thefhiter/masoud/docs/wiring.html

# Masoud wiring

Arduino Uno, the 1.8" screen and the two speakers, with or without the PAM8403 amp. Every pin is labeled as it is printed on the boards. Unplug the USB while you wire, and tick each wire below as you go.

Without amp 1 resistor, quieter With amp PAM8403, louder

1 Screen: 7 wires2 Speakers: 1 resistor, 4 wires

1 Screen: 7 wires2 Amp: 3 wires3 Speakers: 4 wires

The screen takes 3.3V, never 5V. Without the amp, the 220 Ω resistor is not optional: a speaker straight on D3 would burn the pin. The amp takes 5V. Don't swap it with the screen's 3.3V. Nothing goes on D9 or D10 except the screen: those pins drive it.

Without the amp: D3, a 220 Ω resistor, speaker 1, speaker 2, back to GND, all in one loop (the speakers are in series). The screen keeps the same 7 wires; switch to "With amp" to see them drawn.

Top: the screen's 10 pins (3 stay empty). Middle: the Arduino, pins named as printed next to its headers. Right: the amp with its input, power and speaker pins, then the two speakers.

## Wire by wire

0 wires done

### 1 · Screen

Screen VCC→Uno 3.3VBottom header, POWER side. Never 5V. Screen GND→Uno GNDTop header, next to AREF (any GND works). Screen SCK→Uno 13Clock. Screen MOSI→Uno ~11Data. Not MISO, the pin next to it. Screen LCD_CS→Uno ~10Not RAM_CS, the pin next to it. Screen DC→Uno ~9 Screen RST→Uno 8MISO, RAM_CS and BL stay empty.

### 2 · Speakers, no amp

Uno ~3→Resistor, leg 1Either leg: a resistor has no direction. Resistor, leg 2→Speaker 1, wire 1220 Ω = red, red, brown stripes. 150 to 330 Ω also works. Speaker 1, wire 2→Speaker 2, wire 1Speakers in series. Their wires have no direction either. Speaker 2, wire 2→Uno GNDAny GND pin.

### 2 · Amp

Uno ~3→Amp L and ROne wire from D3, split to both inputs. Same sound on both speakers. Uno 5V→Amp +5VMay be printed VCC, 5V or +. Uno GND→Amp GNDPower ground, printed GND or −. The input's G can stay empty.

### 3 · Speakers

Speaker 1, wire 1→Amp L+The + wire if your speaker is marked. Speaker 1, wire 2→Amp L−L− is not ground: never join it to GND. Speaker 2, wire 1→Amp R+ Speaker 2, wire 2→Amp R−R− is not ground either.

Clear all ticks

## Finding the pins on your amp

PAM8403 boards come in a few versions and print the same pins with different names. Match yours here.

Input (from the Arduino)

L R plus a ground marked G, ⏚ or GND. Sometimes LIN / RIN. Usually a row of 3 small pins on one edge.

Power

+5V, VCC or + takes the Uno's 5V. GND or − takes the Uno's GND. Usually 2 pins, sometimes marked in red.

Speakers

L+ L− and R+ R−, or LOUT+ LOUT−, ROUT+ ROUT−. On boards with 2 screw terminals, the one marked L is speaker 1 and the one marked R is speaker 2.

If your board looks different, send a photo of it in the chat and the pins will be marked for you.

## Before you plug in the USB

1. Screen VCC is on 3.3V, not 5V.
2. The resistor sits between D3 and the speakers, never left out.
3. No speaker wire touches GND or the Arduino.
4. D9 and D10 only go to the screen (DC and LCD_CS).
5. Bare wire ends don't touch each other, especially under the amp.
