thefhiter/masoud/(commit log)

2026-10-15 Masoud: brand, launch book, logo files and prototype firmware
    - brand/: mark, app icons and wordmarks as plain SVG paths (Rubik 800),
    launch-book.html (name, logo, colors, type, Derja voice, first-run
    setup with Local/Cloud/Pet mind, parts, pricing, 90-day plan)
    - firmware/masoud_uno: face engine on Uno + 1.8in ST7735S, Masoud boot
    logo on Lucky Yellow, 9 Derja moods incl. Dawkha! (dizzy) for the
    coming shake sensor, serial control
    - tools/: PC preview (same code, partial==full check), splash and logo
    generators
2026-10-15 Glow face and a voice: PAM8403 + speakers on D3, mood chirps, Tunisian speech
    - face: top-lit gradient eyes, two-step glow, glints that drift with the
    gaze, blush when happy; overlaps resolved per row by priority, still
    one write per pixel (PC check: partial == full repaint, 0 mismatches)
    - masoud_audio.h: same amp and speakers as arduino-sound-player, moved
    to D3/Timer2 (D9/D10 drive the screen); Timer1 = 8 kHz sample clock;
    synthesized chirp per mood + hello; PC speech stream with the credit
    protocol at 115200 (0x01 starts it), pumped between rows mid-frame
    - eyes pulse with the voice level while he talks
    - tools/masoud_say.py: text -> edge-tts ar-TN-HediNeural -> pitch up,
    ban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
    [emo_face.h, masoud_audio.h, masoud_say.py, masoud_uno.ino]
2026-10-15 Read the panel's power mode with interrupts off
    The 8 kHz audio interrupt must not land inside the ~40 us bit-banged
    RDDPM read.
2026-10-15 Wiring schematic: Uno, screen, PAM8403 amp and both speakers
    docs/masoud-wiring.svg (pins named as printed on each board, one wire
    crossing) and docs/wiring.html with a tick-off checklist, a guide to
    the label variants on PAM8403 boards, and pre-power checks.
2026-10-15 Speakers without the amp: one resistor, speakers in series
    - audio rests at 0 V in silence and ramps to the midpoint over 16 ms
    around each sound: no DC through a speaker wired straight to D3, no pop
    - docs/masoud-wiring-no-amp.svg + wiring page With amp / Without amp
    switch (checklist and drawing follow the choice)
    - streaming flag volatile (read by the sample interrupt)
2026-10-15 Voice verified on the board: speech streams with 0 dropouts
    - underruns now count only real gaps (dry samples followed by more
    audio); the drain after the last chunk was being counted (~240 per
    clip regardless of length: 5.5 s and 19.5 s clips both ~240, now 0)
    - audio pumped at every screen row via a Sink::row() hook
    - panel watchdog re-inits only a panel that answered before, never
    mid-speech, and warns once if the screen never answers
2026-10-15 Glow face 3-4x faster on the Uno: 5 fps -> 16-20 fps
    - rows in half-pixel integers: rounded corners, happy arch, glints,
    blush and hearts via a rounded 16-bit integer sqrt and Q8 ratios;
    float geometry converted once per frame (no float in the row loop)
    - each eye emitted as disjoint runs in one pass (glow around halo
    around body around glints) instead of resolving overlapping layers;
    blush and Z clipped into the gaps
    - pixel loop sends bytes back to back with no call per byte (-Os did
    not inline spiWrite): full-screen fill 100.7 ms -> 69 ms
    - PC check: partial == full on all 1283 frames; vs the float version
    only 14 pixels in 1 frame differ (blush touching glow)
    - voice re-verif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
2026-10-15 Talk only: chirps off by default, masoud_live.py makes him speak
    - MASOUD_CHIRPS defaults to 0: his only sound is his voice
    - tools/masoud_live.py keeps the port open, greets, and says a Derja
    line on every mood change (his own or sent); typed sentences are
    spoken; lines cached in %LOCALAPPDATA%\masoud\voice
    - verified on the board: greeting + two self-chosen moods spoken,
    0 underruns
2026-10-15 Louder voice without the amp + speaker test tone
    - speech was averaging 3/127 of full swing: inaudible through 220 ohm
    on small speakers. New chain (dynaudnorm, 20:1 compressor, +24 dB,
    x6, limiter) averages ~34/127 while talking; Whisper still
    transcribes it word for word
    - 't' key plays a full-swing 1 kHz square for 1.5 s (works even with
    chirps off): the loudest this wiring can make, to check the speakers
    - voice cache keyed v3 so old quiet clips are re-rendered
2026-10-15 He always talks: idle chatter, autostart, reconnect
    - masoud_live.py: after ~30 s of quiet he says something by himself
    (11 Derja lines + good morning/afternoon/evening/night by the clock,
    no repeats of the last 4), plus every mood change
    - --install: Startup shortcut running pythonw --wait (waits for him,
    reconnects after unplugging, logs to %LOCALAPPDATA%\masoud\live.log);
    --stop frees the USB port for uploads; --uninstall
    - single instance via a PID file; Bluetooth COM ports skipped
    - verified: greeting + 2 self-started lines; background instance found
    COM14 and greeted
    [masoud_live.py]
2026-10-15 AI mind: he answers your messages from the PC
    - masoud_mind.py: a short Derja answer plus a face mood for any message.
    Minds: Claude API, Groq (gpt-oss-120b, falls to the next model if one is
    retired), Claude CLI, Ollama, Pet; Auto uses the first that works and
    skips a failing one for 5 minutes.
    - masoud_live.py serves a chat page on 127.0.0.1:8766 (local only, other
    sites refused): text shows in about 1 s, his face takes the mood, voice is
    rendered in order in the background; console chat goes through the
    running talker; --install adds a Desktop shortcut.
    - masoud_chat.html: his live face mirrors the robot, mood buttons, He
    answers / He says it, mind picker with keys kept on t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
    [masoud_live.py, masoud_mind.py]
2026-10-15 He never goes quiet: a failing mind falls back to the next one
    Choosing Claude CLI while it was signed out made every answer fail, and a
    failed answer was not spoken. Now the chosen mind goes first and the others
    back it up (Pet alone stays alone), the CLI's sign-in is checked in the
    background, the Mind dialog shows 'signed out', and if every mind fails he
    says so out loud.
    [masoud_live.py, masoud_mind.py]
2026-10-15 His Derja: Tunisian only, no MSA, family tone
    - masoud_derja.py: a short Derja guide and original example exchanges for
    every mind, MSA->Derja word swaps on each answer, a check for MSA grammar
    and other dialects that triggers a Derja rewrite, and --eval (24 messages).
    - Measured on Groq: MSA or other-dialect answers 29% -> 0%, off-topic
    coffee/couscous 50% -> 4%, misused 'ya hasra' 2 -> 0, 1.4 s -> 1.1 s.
    - Prompt cut to ~900 tokens for Groq's 8000 tokens/min free tier; a busy
    model hands over to the next Groq model instead of the Pet answers.
    - The time is given to the mind but only said when asked; family-friendly
    rule; slashes like زين/ة removed for the voice.
    [masoud_mind.py]
2026-10-15 He speaks English, French and Arabic (Derja removed)
    - masoud_mind.py answers in the language of your latest message (Arabizi
    gets Arabic), or one fixed language (Mind -> Language on the page); one
    language per answer; --eval: 12/12 in the right language, 1.2 s.
    - One multilingual voice (Remy) for all three; his name is spoken as
    'Massoud' in Latin text (voices said 'Mazou' / 'a sued').
    - His own lines (greeting, mood comments, chatter, clock) in all three,
    following the language he last spoke; rendered in the background, never
    while he talks.
    - masoud_derja.py removed; page shows English mood names.
    - Firmware: speech buffer 256 -> 512 bytes (64 ms): back-to-back answers
    went fr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
    [masoud_audio.h, masoud_live.py, masoud_mind.py, masoud_say.py]
2026-10-23 His AI mind writes what he says on his own, and he talks more
    One call returns a fresh batch: a line for each mood plus five quiet-room
    lines (a question, a fun fact, a joke, the time of day, a reminder), aware of
    the weekday and the latest chat and told not to repeat his last lines. They are
    voiced ahead of time (not cached on disk), so mood comments stay instant; the
    fixed lines fill in when the mind is offline or on Pet. Quiet gap 30 s -> 18 s.
    [masoud_live.py, masoud_mind.py]
